Pedro-Molina/TP4_TP1/Esquematicos.PDF

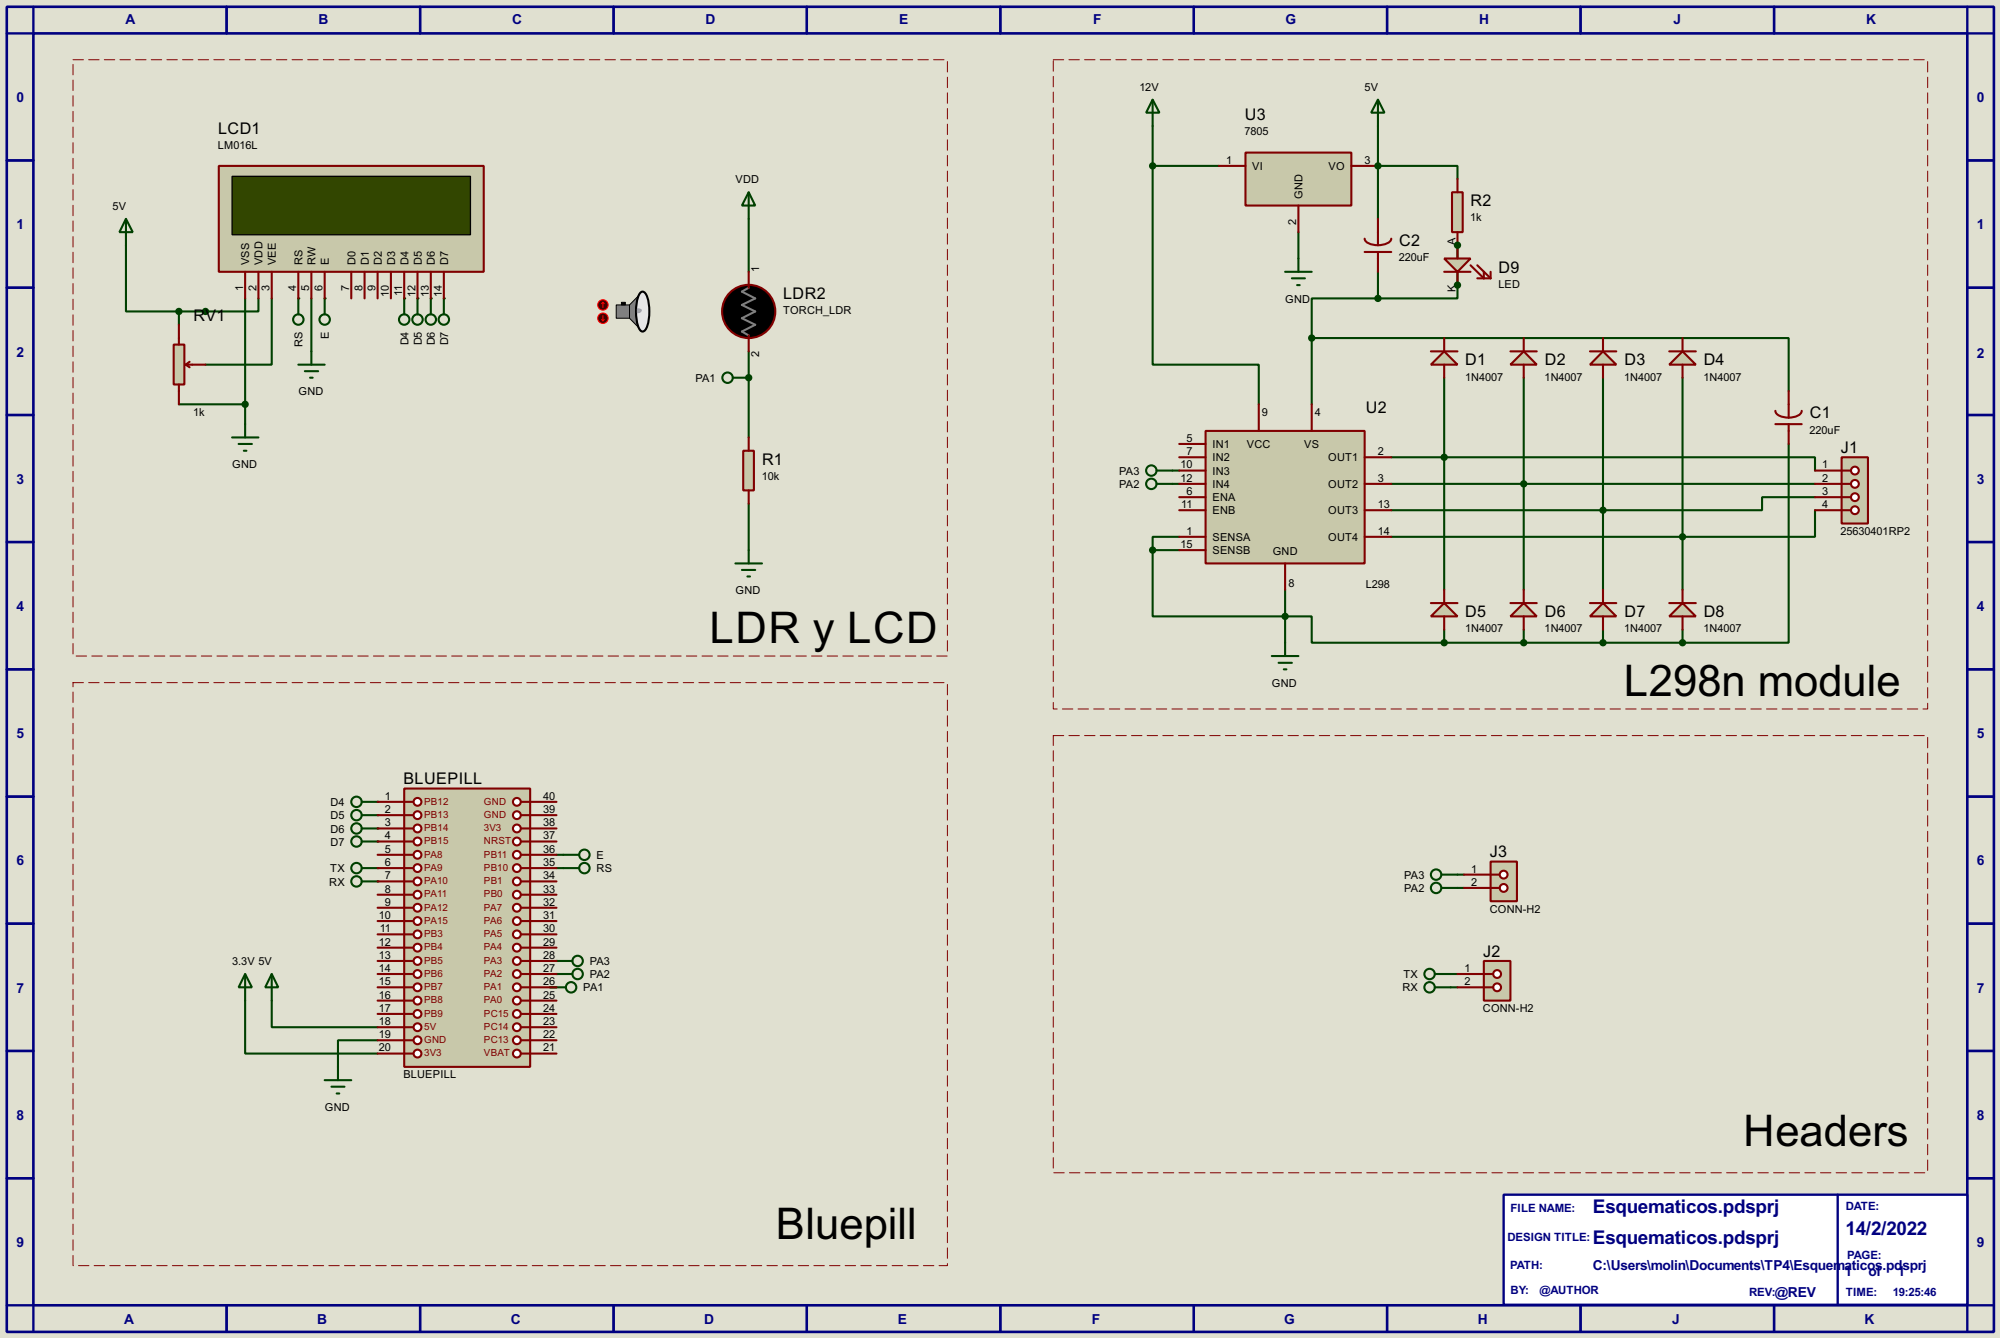
[picture p26: page 1]
