Pedro-Molina/TP4_TP1/(list of files, drawings)

Other design files:
Esquematicos.pdsprj
TP4.pdsprj
