Pedro-Molina/TP4_TP1/(commit log)

2022-02-01 Primer commit
    [TP4.pdsprj]
2022-02-10 anda motor, no anda adc
    [Esquematicos.pdsprj, TP4.pdsprj]
2022-02-10 guarde esquematico
    [TP4.pdsprj]
2022-02-10 integracion fallida
    [TP4.pdsprj]
2022-02-10 cambio proteus
    [TP4.pdsprj]
2022-02-10 Arregle la terminar virtual poniendo una variable antes del IF
    [TP4.pdsprj]
2022-02-11 anda el adc
    [TP4.pdsprj]
2022-02-11 opciones iluminacion
    [TP4.pdsprj]
2022-02-11 implementacion intesidad de luz, agregado LCD
    [TP4.pdsprj]
2022-02-12 andan las opciones y el reloj, tambien imprime config, se cambio la resistensia del divisor de tension
    [TP4.pdsprj]
2022-02-13 no muchos cambios
    [TP4.pdsprj]
2022-02-14 anda FALOPA
    [TP4.pdsprj]
2022-02-14 PCB arreglos, faltan cosas
    [Esquematicos.pdsprj]
2022-02-14 PCB terminado
    [Esquematicos.pdsprj]
2022-02-14 plaqueta mas chica
    [Esquematicos.pdsprj]
2022-02-15 correcion de los rangos
    [TP4.pdsprj]
